cosmic-pi-deprecated/FPGA-hardware/README.md

# FPGA-hardware
FPGA main board for Cosmic Pi
