cosmic-pi-deprecated/FPGA-hardware/cosmicpifpgaOHL.pdf

A

B

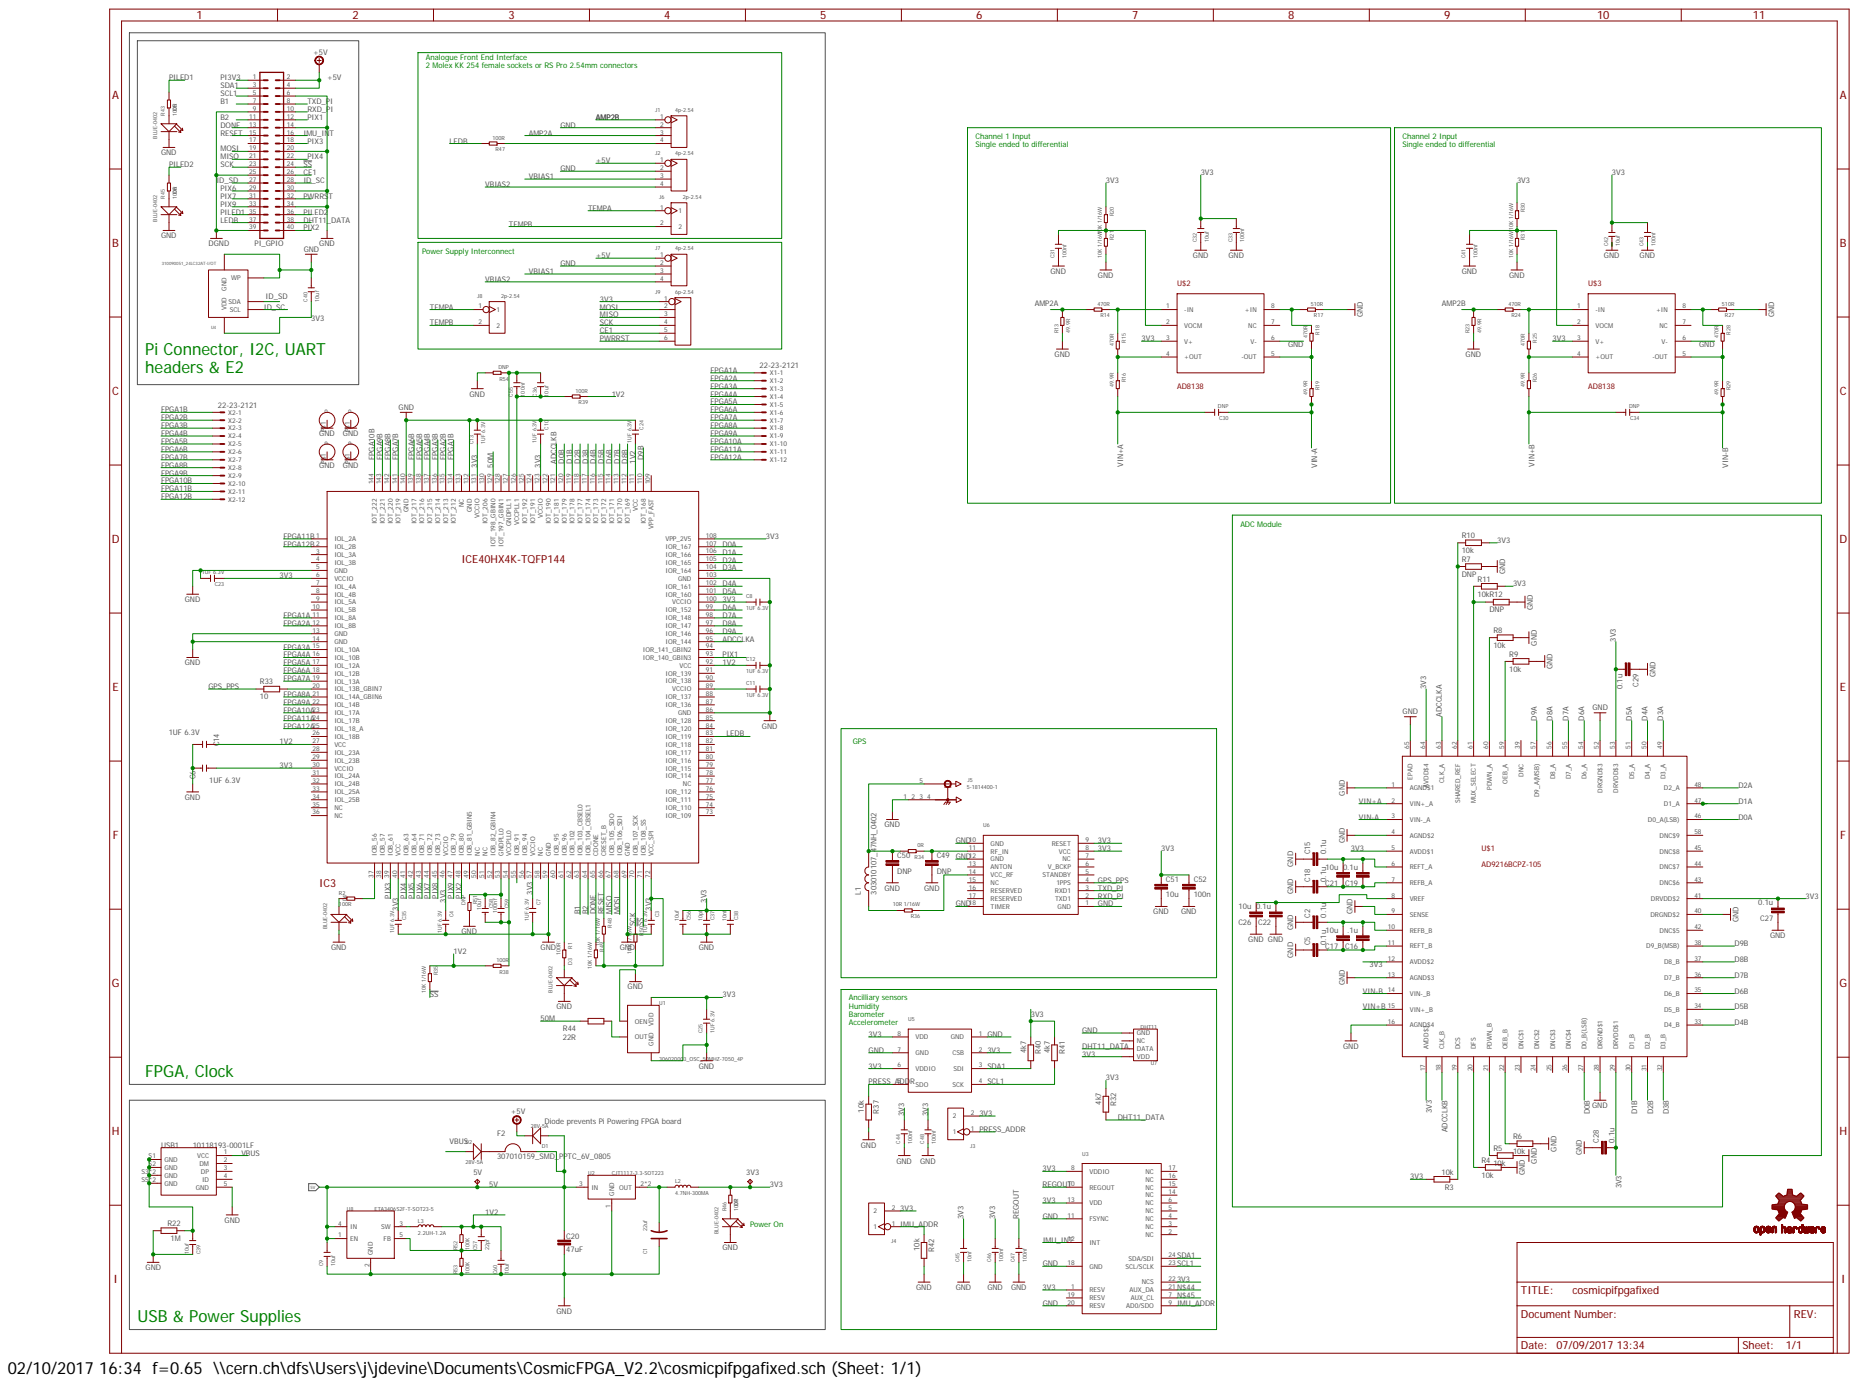
[picture p1: page 1]

Analogue Front End Interface
2 Molex KK 254 female sockets or RS Pro 2.54mm connectors

Channel 1 Input
Single ended to differential

Channel 2 Input

VDD GND SCL SDA WP

VPP_FAST 109 IOT_168 110 VCC 111 IOT_169 112 IOT_170 113 IOT_171 114 IOT_172 115 IOT_173 116 IOT_174 117 IOT_177 118 IOT_178 119 IOT_179 120 IOT_181 121 IOT_190 122 VCCIO 123 IOT_191 124 IOT_192 125 VCCPLL1 126 GNDPLL1 127 IOT_197_GBIN1 128 IOT_198_GBIN0 129 IOT_206 130 VCCIO 131 GND 132 NC 133 IOT_212 134 IOT_213 135 IOT_214 136 IOT_215 137 IOT_216 138 IOT_217 139 GND 140 IOT_219 141 IOT_220 142 IOT_221 143 IOT_222 144

Diode prevents Pi Powering FPGA board

02/10/2017 16:34 f=0.65 \\cern.ch\dfs\Users\j\jdevine\Documents\CosmicFPGA_V2.2\cosmicpifpgafixed.sch (Sheet: 1/1)
