cosmic-pi-deprecated/FPGA-hardware/(commit log)

2017-09-08 First release
    Currently being manufactured by SEEED studio, note that for our first production run of prototypes we haven't included the ADC components to save some money.
    [CosmicPiFPGABOM.csv, CosmicPiFPGABOMwithoutadc.csv, cosmicpifpgaOHL.brd, cosmicpifpgaOHL.sch]
2017-10-02 Fixed mirroring in schematic
